BrennenJohnston/braille-wedge-card-openscad/(commit log)

2026-06-05 docs(experimental): seed braille-business-card research notes
    Adds the two research notes that motivate the Path 2 wedge prototype:
    print-stability/path recommendation and dot-geometry/slicer-quality.
    Branch-only; not merged to main.
2026-07-06 chore(card): baseline snapshot of wedge card generator before public-release refactor
    Pre-refactor state of the experimental leaning braille card generator (emboss/counter plates, indicators, 4 lines) plus the customizer usability research notes. Local feature-branch snapshot only; the presets JSON still contains personal preset sets that are replaced by curated, scrubbed presets before anything is published.
    [Braille_Wedge_Card_STL_Generator.scad]
2026-07-06 refactor(card)!: de-emboss into a pure directly-readable braille card
    Removes all embossing-era concepts from the wedge card generator: plate_type / Counter Plate path, counter recess modules and parameters, row indicators, the _preset_* routing shims, and the parent test-system compatibility shims (combined_shape, indicator_shapes, hemisphere_quality). card_emboss_plate() becomes union-only braille_card() (nothing is subtracted anymore); emboss_dot_* params renamed to cone_dot_*; active_emboss_height renamed to dot_total_height. Header rewritten around the single-card mission with a license line and VERSION 1.0.0. Verified: default render is manifold/NoError.
    [Braille_Wedge_Card_STL_Generator.scad]
2026-07-06 feat(card): 20 text rows, wider size ranges, bed warning, robust fins/bridges
    Line_5..Line_20 added with _all_lines as the single source of truth for every loop, warning, and layout module (with a documented recipe for extending past 20). grid_rows slider now 1-20, manual face size up to 300x250 mm, and a console warning fires when the effective face exceeds 250 mm (common print-bed limit). Watertightness fixes found while stress-testing: dots are embedded 0.02 mm into the face (exact coplanar seating exported dots as hundreds of floating shells), the fin brim stops short of the card's bottom-back corner, and bridges keep 0.1 mm clearance below the fin top plane -- plus the planned clamp so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
    [Braille_Wedge_Card_STL_Generator.scad]
2026-07-06 feat(card): Try_4 first-run defaults + curated scrubbed presets
    Defaults now match the print-tested Try_4 preset with warnings kept On: fins 25 mm/1.0 offset/1.2 thick, bridges 6x 0.5/0.5 at 0.3 contact, brim 2/0.2, card 1.5 mm thick, cell spacing 7.0, grid 11x5, rounded dot 1.6/0.35 + 1.4/0.35 (0.7 mm total, ADA-legal), render High with 40 cone segments. Presets JSON rewritten as three curated sets (Default Card, Compact Card (manual 75x25) from the FinsT2 fin/bridge values, Large 20-Line Card) using the new cone_dot_* names, no emboss/counter/indicator keys, and generic sample braille only -- the personal sets live on in an untracked *.local.json. Also fuses the rounded dot's dome to its b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
    [Braille_Wedge_Card_STL_Generator.scad]
2026-07-06 feat(card): self-contained project folder (docs, tests, CI, license)
    Restructures experimental/braille-business-card/ into a standalone repo-in-waiting: README (quick start, Customizer walkthrough, print guidance, preset loading, troubleshooting, MakerWorld upload steps incl. the license-choice flag, research credits), CHANGELOG v1.0.0, PolyForm NC LICENSE copy, .gitignore (*.local.json for personal presets), .gitattributes, pytest.ini, research notes moved to docs/. New lean test suite with no parent imports: test_customizer (dropdown hygiene + preset key/scrub checks), test_source_guards (20-line wiring, %-wrapped warnings, mission guard against embossing-era tokens), test_render_smoke (4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
    [Braille_Wedge_Card_STL_Generator.scad]
2026-07-06 fix(card-tests): add scipy to test requirements
    trimesh delegates its connected-component body_count check to scipy.sparse.csgraph; without scipy the render smoke tests fail on a clean CI runner (the local venv had scipy installed, masking the missing pin).
2026-07-13 feat: sign and charm generators, multi-card layout (v1.1.0)
    Expand the repo into three self-contained MakerWorld-ready generators:
    - Braille_Sign_STL_Generator (two-part ADA-style tactile sign) + presets
    - Braille_Charm_STL_Generator (pendants + bracelet C-clip) + presets
    - Card 1.1.0: multi-card All-cards layout, print-tested first-run
    defaults (auto-size on, warnings off, Medium quality), new presets
    Tests are parametrized across all three generators (Customizer hygiene,
    MakerWorld single-file guard, render smoke incl. two-body layouts); CI
    validates all three preset JSONs. Docs updated accordingly.
    [Braille_Charm_STL_Generator.scad, Braille_Sign_STL_Generator.scad, Braille_Wedge_Card_STL_Generator.scad]
2026-07-13 fix(tests): all-cards smoke test expected auto-sized cards to be manual
    test_all_cards_two_card_layout predicted the bounding box from the
    manual 200 x 100 mm face, but auto_size_card defaults to On, so each
    card in the All-cards layout auto-sizes to its own 8-row x 10-cell
    chunk. Predict the bbox from the auto-size formula instead.
2026-07-13 docs: redraw print-orientation ASCII diagram, add status badges
2026-07-27 refactor!: narrow this repo to the wedge card (v1.2.0)
    The sign and charm generators moved to braille-sign-openscad and
    braille-charm-openscad, each at its own v1.0.0.
    The three generators shared nothing but a test harness and a README — no
    OpenSCAD include/use between them — so keeping them together meant every
    release note and every CI run discussed two tools the reader did not care
    about, and each generator's version number had to move whenever a sibling
    changed. Their development history stays here in the v1.1.0 work; the new
    repos start fresh and say so.
    Trims what the split leaves behind: conftest declares one .scad (so the
    Customizer and MakerWorld guards no longer parametrize o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
    [Braille_Charm_STL_Generator.scad, Braille_Sign_STL_Generator.scad, Braille_Wedge_Card_STL_Generator.scad]
2026-07-27 ci: pin ruff and declare the rule set explicitly
    CI installed ruff unpinned, so the lint verdict depended on which version
    pip happened to resolve that day. Ruff 0.16 turned UP/PIE/BLE/PLW/RUF on by
    default and failed the lint job on an unchanged tree — 29 findings in code
    that had passed hours earlier.
    Adds ruff.toml selecting E + F + I with E501 ignored, which is what the
    suite was actually written against, and pins ruff==0.16.0 in the workflow
    so the rules and the version both live in the repo. The --ignore E501 flag
    moves out of the workflow into the config.
    known-first-party covers conftest and openscad_runner: pytest puts tests/
    on sys.path so they are imported by bare name, and wi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
2026-08-02 refactor(customizer): move Line_9-Line_20 to an Advanced group (v1.2.1)
    All twenty text fields sat in the first Customizer tab, so opening the
    panel meant scrolling past twelve usually-empty boxes to reach card
    size, fins, or anything else. Lines 1-8 stay in
    [Text Input - Pre-Translated Braille], matching the grid_rows default
    of 8; the rest move to [More Braille Lines (Advanced)].
    Presentation only: the parameter names, the _all_lines wiring, and the
    twenty Line_N keys in Braille_Wedge_Card_STL_Generator.json are
    unchanged, so existing presets, multi-card layouts, and -D overrides
    behave exactly as before. OpenSCAD's Customizer cannot show or hide
    fields based on other settings, so a secon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
    [Braille_Wedge_Card_STL_Generator.scad]
2026-08-02 Add the MakerWorld listing and quick start
    Both documents existed on disk but were never committed, so the README links
    to them and every cross-project citation of them resolved to a 404.
    The README gains the Release documentation section that points at them, and
    corrects the MakerWorld warning note: the card ships with show_warnings off and
    the Parametric Model Maker has no visible console, so the old wording promising
    console echo described feedback the user cannot reach. Warnings have to be
    switched on in the Warnings tab to render as 3D text on the model.
    The shared standard the two documents are written to now lives in
    accessible-makerworld-doc-standard rather than this repository, si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
2026-08-02 Bump checkout, setup-python, and upload-artifact to v7
    The v4/v5 pins run on the deprecated Node 20 runtime. This is catching up with
    the rest of the family rather than diverging: braille-cylinder-stl-generator
    already runs @v7 across all three actions and its CI is green.
